simple-circuit/EFMRI/README.md

# EFMRI
Earth's Field MRI

This project outlines the use of available resources to build
an Earth's Field MRI system. It is a complex project. Aligning
and adjusting the system is a timely process. Also, the small
signal relay is no longer available. A Panasonic TX2-5V Telecom Relay
may be substituted.

You do not have to build the project to generate images. Data files
are supplied that can be loaded and processed with the supplied
user interface.

Note: For the Polarizer board, use the updated Profile_polarizer_e2.gcode
file. This corrects the unused relay pin which is open, not grounded.
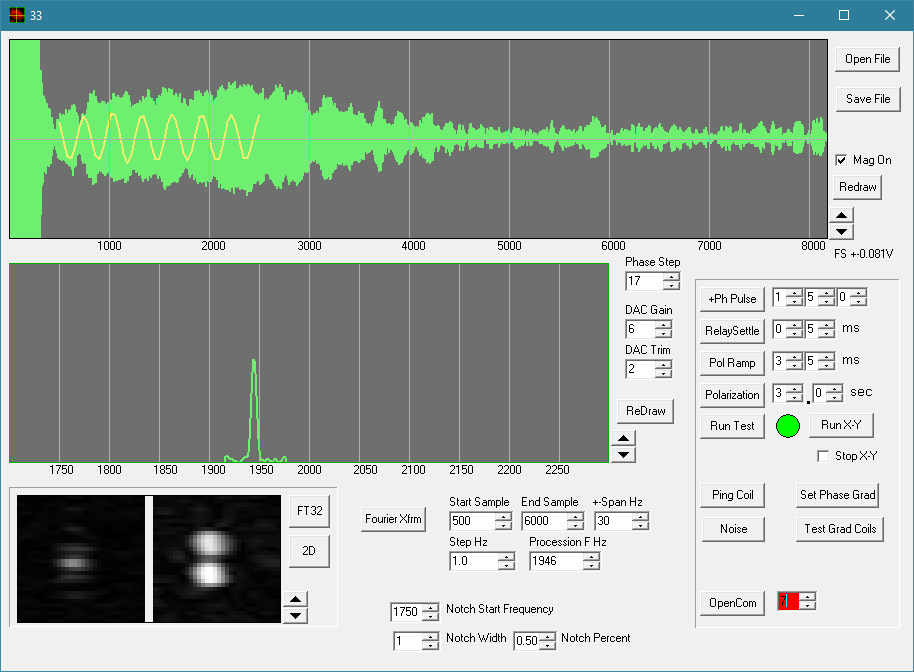
[picture p1: vert_new_cir.png]
