simple-circuit/EFMRI/(list of files, cad)

Other CAD files:
simpleMRI_code/simpleMRI.obj
